orange445/portable-gas-sensor-stm32/README.md

# 便携式气体传感器测量板

本项目使用小型锂电池供电，在阻性气体传感器两端持续施加约 2.000 V，主要测量图示约 0.2–1.6 µA 的单向电流，并为瞬态和样品差异预留约 10 倍电流余量，通过蓝牙把电流、阻值、偏置和电池状态发送到手机或上位机。

## 当前冻结方案

- 传感器：无源阻性器件，默认不含加热器
- 传感器偏置：`VCM - VFORCE ≈ 2.0016 V`
- 主要测量范围：约 0.2–1.6 µA；宽量程告警上限 20 µA，25 µA持续过流关断
- 主要范围对应电阻：约 10 MΩ–1.25 MΩ；25 µA保护点约80 kΩ
- 电流前端：OPA391 宽量程 TIA，`Rf = 12 kΩ`，`Cf = 47 nF`
- 主控：STM32G030F6P6TR，TSSOP-20
- 采集：STM32 12 位 ADC 单端扫描，固件执行差分相减和过采样
- 蓝牙：VG6328A-Pro 串口透传模块，STM32 与模块用 UART 连接
- 供电：单节保护型 LiPo + USB-C/TP4054 充电 + 3.0 V LDO
- 产品方向：低成本、小面积、可调试、适合连续气体/呼吸响应曲线采集

## 设计文档

1. [功能规格](docs/01_功能规格.md)
2. [系统架构与电源树](docs/02_系统架构与电源树.md)
3. [STM32与BLE引脚分配及布局约束](docs/03_BLE引脚分配与布局约束.md)
4. [原理图实施记录](docs/04_原理图实施记录.md)
5. [电学验收与计算](docs/05_电学验收与计算.md)
6. [低成本替换与验收](docs/06_低成本替换与验收.md)
7. [硬件整体结构与关键电流方向](docs/images/06_硬件整体电流图.svg)
8. [项目硬件基线与验证计划](PROJECT_EGFET_BASELINE.md)
9. [STM32CubeMX配置基线](docs/07_STM32CubeMX配置.md)
10. [可导入的CubeMX工程](firmware/cubemx/GasSensor_STM32G030F6.ioc)
11. [固件、串口协议与上位机说明](docs/08_固件与上位机协议.md)
12. [气体传感上位机](tools/serial_curve_plotter.html)

## 当前进度

- [x] 功能与量程冻结
- [x] 电源、充电和模拟前端原理图
- [x] 主控改为 STM32G030F6P6TR
- [x] 独立蓝牙模块、UART、唤醒和电源滤波
- [x] ADC、I2C、复位和 SWD 引脚冻结
- [x] 5针SMD Pogo烧录焊盘加入PCB、不进入BOM
- [x] STM32主去耦统一为0603
- [x] 三页器件按功能分区
- [x] 原理图严格 DRC：无新增错误
- [x] STM32CubeMX 引脚、ADC、DMA、TIM3、UART和I2C配置
- [ ] 封装与 BOM 最终复核
- [ ] PCB 布局布线与 DRC
- [x] STM32 气体采集固件、串口协议与 Web Serial 上位机第一版
- [x] VG6328A-Pro BLE GATT直连、掉线诊断与退避重连
- [x] 已从任务历史精确恢复固件0.2.1：10 Hz默认输出、150 ms预热、经典UART透传流程
- [ ] 样机校准与噪声测试
