orange445/portable-gas-sensor-stm32/PROJECT_EGFET_BASELINE.md

# 便携式气体传感测量板硬件基线

基线编号：`GS-HB-0.2`  
建立日期：2026-07-26  
项目：`GasSensor_Main`  
状态：原理图与固件联调阶段，尚无样机测量证据  
模板来源：`portable-egfet-engineering/project-handoff.md`

> 本项目不是EGFET扫描仪，没有DAC、栅极扫描或电化学参比电极。本基线沿用同一证据链方法，将链路改写为：
>
> `ANA_EN/固定偏置 -> 3VA -> VREF/VCM/VFORCE -> 阻性气体传感器 -> TIA -> STM32 ADC -> 固件换算 -> UART -> BLE -> 上位机`
>
> 本文件同时作为一个“经验来源项目”保存。后续项目只继承设计与调试方法，不自动继承2 V、12 kΩ、STM32引脚、BLE型号、阈值或机械尺寸。

## 1. 证据等级

- `FACT-DESIGN`：从当前设计文档、原理图截图或器件数据手册确认。
- `FACT-EDA-REPORT`：由既有EasyEDA API验收记录确认，但本次未能在线重读。
- `MEASURED`：在具名板卡、仪器和测试条件下得到的实测结果。
- `HYPOTHESIS`：合理但尚未通过区分实验验证。
- `DECISION`：当前选定的实现方法及其取舍。
- `PROPOSED`：建议的验收门槛，尚待项目负责人冻结。
- `WORKAROUND`：临时补偿；当前没有获准的工作绕行项。

当前没有任何 `MEASURED` 证据。本文出现的电压、电流和误差值，除非明确标记为实测，均为标称值、计算值或数据手册边界。

## 2. Objective

### 2.1 科学量

- 主要输出：传感器单向电流 `Isensor`，单位µA或nA。
- 派生输出：传感器实际偏置 `Vsensor`，单位V。
- 派生输出：传感器电阻 `Rsensor = Vsensor / Isensor`，单位Ω。
- 辅助输出：`VCM`、`VFORCE`、`TIA_OUT`、电池电压、USB存在状态、充电状态和质量标志。
- 非当前输出：气体浓度。没有标准气体标定曲线前，不得把电流或阻值直接标成ppm。

### 2.2 设计范围

| 项目 | 当前值 | 证据状态 |
|---|---:|---|
| 主要使用范围 | 0.2–1.6 µA | `FACT-DESIGN`，来自先前实验曲线 |
| 过量程观察范围 | 1.6–20 µA | `DECISION`，尚未实测精度 |
| 软件告警 / 保护关断 | 20 µA / 25 µA | `DECISION` |
| 传感器偏置 | 约2.0016 V | `FACT-DESIGN`，必须在器件带载时测量 |
| 主要范围对应电阻 | 约10.008–1.251 MΩ | 由标称偏置计算 |
| 信号带宽 | 低于数Hz | `FACT-DESIGN` |
| 默认对外数据率 | 20 sample/s | `DECISION`，固件尚未实现 |
| 可选数据率 | 0.1–50 sample/s | `DECISION`，固件尚未实现 |

12 kΩ反馈下0.2 µA仅约3.3个理论差分码，必须通过样机的零点、噪声、过采样和多点校准验证，不能把“有输出码”当作低端准确度。

### 2.3 参考仪器与验收

- 参考仪器：尚未指定。至少需要一台校准有效的6½位DMM，以及0.1%或更高精度、低温漂的80 kΩ、100 kΩ、125 kΩ、1.25 MΩ和10 MΩ电阻。
- 当前已冻结的电压窗口见第11节。
- 电流准确度与重复性尚未由用户冻结。
- `PROPOSED` 首轮工程门槛：校准后电流误差不超过 `max(读数的2%, 20 nA)`，安静台架下固定电阻30分钟重复性不超过10 nA RMS。该门槛需要根据实际应用再确认，当前不能作为已通过指标。

## 3. Hardware Revision

### 3.1 板卡与资料状态

| 项目 | 当前状态 |
|---|---|
| 硬件修订 | `GS-HB-0.2`，TIA宽量程原理图候选 |
| EasyEDA工程 | `GasSensor_Main` |
| 主原理图UUID | `6c0ba00e583160b9` |
| 电源页 | `01_Power_Charge` / `afbb84e5bb136422` |
| 模拟前端页 | `02_AFE_TIA` / `3947cc366d9220d3` |
| STM32/BLE页 | `03_STM32_BLE_Debug` / `9738889853545ddc` |
| PCB/Gerber | PCB存在，但本次电气修改明确未同步到PCB |
| STM32Cube `.ioc` | 已建立；本次Rf/Cf变化不改外设映射 |
| MCU固件/驱动 | 已建立，默认Rf已改为12 kΩ |
| BLE配置与协议 | UART透传协议已建立 |
| 上位机/手机工具 | `tools/serial_curve_plotter.html`已支持气体传感页面 |
| 原始串口记录/CSV | 未找到 |
| 结构件源文件 | 未找到 |

`FACT-EDA-REPORT`：既有记录显示三页共59个实体器件，严格原理图DRC为0错误和4条既有非电气警告。2026-07-26在线确认模拟前端页，并将R17改为12 kΩ、C13改为47 nF后保存；本次没有同步或改动PCB。

`REJECTED/ARCHIVE`：`docs/datasheets/MDBT42Q_512KV2_VerP.pdf`属于旧nRF方案，不是当前STM32 + VG6328A-Pro设计的器件依据。

### 3.2 MCU与时钟

- U7：STM32G030F6P6TR，TSSOP-20。
- Flash/RAM：32 KB / 8 KB。
- 供电与ADC参考：`VDD/VDDA = 3V0`，TSSOP-20中ADC参考内部接VDDA。
- 时钟：CubeMX基线使用内部16 MHz HSI直连，不启用PLL；115200 UART全温误差仍需实测。
- 调试：PA13/PA14 SWD，另有NRST、3V0和GND五针Pogo接口。

### 3.3 电源轨

| 电源/节点 | 标称范围 | 来源 | 当前用途 |
|---|---:|---|---|
| USB_VBUS | 5 V | USB-C | TP4054充电、VBUS检测 |
| BAT | 3.0–4.2 V | 保护型单节LiPo | 系统输入 |
| 3V0 | 3.0 V | ME6211C30M5G | STM32、BLE前级、模拟开关输入 |
| BLE_3V0 | 接近3V0 | 3V0经FB1 | VG6328A-Pro |
| 3VA_SW | 接近3V0 | TPS22919 | 模拟滤波前 |
| 3VA | 约2.93–2.99 V | 3VA_SW经22 Ω | LM4040、TLV9002、OPA391 |
| VREF_2V5_RAW | 约2.5 V | LM4040A25 | 模拟基准 |
| VCM | 约2.5 V | TLV9002-A缓冲 | TIA虚拟地、ADC参考采样 |
| VFORCE | 约0.4984 V | 100 kΩ/24.9 kΩ + TLV9002-B | 传感器低端固定电位 |

### 3.4 连接器与接口

- USB-C：仅5 V充电，不使用USB数据。
- LiPo：实际连接器型号、极性和封装尚未在基线中冻结。
- 传感器：RS1仅为电气模型，不进BOM/PCB；实际电极、焊盘或连接器未冻结。
- J4五针Pogo：1=3V0，2=SWDIO，3=SWDCLK，4=RESET_N，5=GND。
- BLE：U8板载天线，UART和WAKE连接STM32。
- 预留I2C：PA11/PA12，当前没有已装传感器。

## 4. Measurement Chain

### 4.1 完整证据链

| 阶段 | 节点 | 标称范围 | 增益/偏移/极性 | 主要限制 | 证据 |
|---|---|---:|---|---|---|
| 0. 测量启停 | `ANA_EN` | 0/3V0 | 高电平打开TPS22919 | 复位时必须保持低 | `FACT-DESIGN` |
| 1. 模拟电源 | `3VA` | 约2.93–2.99 V | 3V0经开关、22 Ω和本地电容 | 负载、LDO跌落和BLE回流 | `FACT-DESIGN`，待实测 |
| 2. 基准 | `VREF_2V5_RAW` | 约2.5 V | LM4040A25，3.9 kΩ偏置 | 全温最小阴极电流80 µA | 数据手册 + 设计计算 |
| 3. 共模 | `VCM` | 约2.5 V | TLV9002-A单位增益缓冲 | 输出摆幅、负载与温漂 | `FACT-DESIGN` |
| 4. 低端偏置 | `VFORCE` | 约0.498399 V | `2.5×24.9/(100+24.9)` | 分压误差、缓冲失调 | 设计计算 |
| 5. 被测器件 | `SENS_H`到`VFORCE` | 约2.001601 V | `Vsensor=VCM−VFORCE` | 必须测器件两端实际电压 | 设计计算，待实测 |
| 6. 传感器电流 | `Isensor` | 主范围0.2–1.6 µA，保护点25 µA | 常规电流从SENS_H/VCM侧经传感器流向VFORCE | 开路、漏电、污染、寄生电容 | `FACT-DESIGN` |
| 7. 跨阻转换 | `TIA_OUT` | 主范围2.5024–2.5192 V，保护点2.800 V | `TIA_OUT=VCM+Isensor×12 kΩ` | OPA391高端共模/输出余量、Rf/Cf | 设计计算 + 数据手册 |
| 8. ADC输入网络 | `AIN_TIA/VCM/VFORCE` | 0.498–2.800 V | 各串1 kΩ、各10 nF到GND | 通道切换和电容重分配 | `FACT-DESIGN` |
| 9. ADC码 | PA0/PA1/PA4 | 0–4095码 | 3.0 V时0.7326 mV/LSB | ADC TUE、INL、VDDA、采样时间 | STM32数据手册 |
| 10. 数字差分 | `Vdiff` | 主范围2.4–19.2 mV，保护点300 mV | `V(TIA)−V(VCM)` | 两次单端采样并非同时采样 | 固件已实现 |
| 11. 电流换算 | `Isensor` | 主范围0.2–1.6 µA | `(Vdiff−Vzero)/Rf_cal` | 校准系数和单位 | 固件已实现 |
| 12. 电阻换算 | `Rsensor` | 主范围1.251–10.008 MΩ | `(VCM−VFORCE)/Isensor` | 小电流时除法敏感 | 固件已实现 |
| 13. 串口帧 | USART2 | 默认候选115200 bit/s | PA2 TX到U8 RX，PA3 RX来自U8 TX | 帧格式、CRC、拥塞尚未定义 | 原理图确认，协议缺失 |
| 14. 无线链路 | VG6328A-Pro | BLE透传 | 模块承担射频与BLE | 服务UUID、睡眠和重连策略缺失 | `FACT-DESIGN` |
| 15. 用户输出 | 手机/上位机 | 未定义 | 应显示原始量、校准量和质量标志 | 主机工具与CSV格式缺失 | 未实现 |

### 4.2 独立计算

```text
VFORCE = 2.5 × 24.9 / (100 + 24.9)
       = 0.4983987 V

Vsensor = 2.5 - 0.4983987
        = 2.0016013 V

ADC_LSB = 3.0 / 4095
        = 0.7326007 mV

I_LSB_nominal = ADC_LSB / 12 kΩ
              = 61.050 nA/LSB

fTIA = 1 / (2π × 12 kΩ × 47 nF)
     = 282.19 Hz
```

| 电流 | 等效电阻 | `TIA_OUT` | 标称差分码 |
|---:|---:|---:|---:|
| 0.2 µA | 10.008 MΩ | 2.5024 V | 3.28 |
| 1.6 µA | 1.251 MΩ | 2.5192 V | 26.21 |
| 16 µA | 125.1 kΩ | 2.692 V | 262.08 |
| 20 µA | 100.08 kΩ | 2.740 V | 327.60 |
| 25 µA | 80.06 kΩ | 2.800 V | 409.50 |

### 4.3 关键边界

1. `FACT-DATASHEET`：STM32G030 ADC的总未调整误差在数据手册条件下典型3 LSB、最大6.5 LSB；ENOB典型约10.2 bit。0.2 µA只有3.28个理论差分码，因此过采样不能替代零点、增益和多点校准。
2. `FACT-DATASHEET`：12位ADC在35 MHz时，1 kΩ源阻从7.5个采样周期开始满足数据手册表格条件；本项目仍应选更长采样时间，并验证各通道10 nF对地电容后的通道切换。
3. `FACT-DESIGN`：AIN_TIA、AIN_VCM和AIN_VFORCE各有1 kΩ串联与10 nF对地，单路名义极点约15.9 kHz。扫描顺序和等待时间必须通过示波器/ADC原始码验证，不能只按单路RC估算。
4. `FACT-DATASHEET`：OPA391无负载输出典型距电源轨3 mV、最大约10 mV；设计最大输出2.800 V对最低估计3VA=2.93 V仍有约130 mV余量。余量看似足够，但必须在温度、BLE发射和低电池条件下实测。
5. `FACT-DATASHEET`：OPA391在接近正电源轨的高共模区域精度规格变差。本设计VCM约2.5 V、3VA约2.93–2.99 V，应把TIA零点随温度和电源的变化纳入校准。
6. `FACT-DATASHEET`：LM4040A25全温最小阴极电流为80 µA。3VA=2.93 V时，经3.9 kΩ的标称电流约110 µA，只有约30 µA余量；应实测最低电池、最高温和器件容差组合。

## 5. Peripheral Configuration

### DAC

- 无DAC。
- 固定偏置由LM4040、TLV9002和电阻比产生。
- 任何未来加入可变偏置或扫描功能的改动，都必须重新建立DAC设定值到器件实际端电压的证据链。

### ADC

- MCU：STM32G030F6P6TR内部12位ADC。
- 固定扫描顺序：PA0 `AIN_TIA`、PA1 `AIN_VCM`、PA4 `AIN_VFORCE`、PA5 `BAT_SENSE`、PA6 `VBUS_SENSE`、内部`VREFINT`。
- `CHG_STAT_N`：PA7数字输入。
- CubeMX基线：ADC时钟4 MHz、160.5周期采样、64×硬件过采样/右移6位、TIM3 TRGO 20 Hz触发、DMA1 Channel 1循环搬运6个半字。
- ADC自校准、模拟前端稳定等待和丢弃前2帧属于固件启动状态机，不能仅依赖CubeMX生成代码。
- 配置文件：`firmware/cubemx/GasSensor_STM32G030F6.ioc`。

### UART/BLE

- USART2：PA2 TX、PA3 RX。
- 基线波特率：115200 bit/s、8-N-1；内部RC全温误差尚未验证。
- `BLE_WAKE`：PB6到U8 PA9，空闲高电平、下降沿脉冲唤醒。
- AT命令版本、服务UUID、连接参数、批量发送策略：未定义。

### 定时器与时间戳

- TIM3以16 MHz时钟、PSC=15999、ARR=49产生20 Hz硬件触发。
- ADC DMA每次触发输出一帧6个过采样结果；样本序号、时间戳宽度、溢出规则和丢帧处理仍由应用固件定义。

## 6. Calibration

### 6.1 必须保存的原始量

- 每个ADC通道的原始码。
- VREFINT原始码和换算后的VDDA。
- `TIA_OUT`、`VCM`、`VFORCE`的平均值与标准差。
- `BAT_SENSE`、`VBUS_SENSE`、充电状态。
- BLE发射/连接状态、样本序号和时间戳。
- 板号、硬件修订、固件版本、校准日期和环境温度。

### 6.2 电压校准

1. 使用DMM测量3V0、3VA、VCM、VFORCE和TIA_OUT。
2. 同步记录ADC原始码和VREFINT。
3. 建立每块板的ADC增益/偏移或至少验证VREFINT换算误差。
4. 验证带载传感器两端的实际 `VCM - VFORCE`，不使用固定2.000 V替代实测值。

### 6.3 电流校准

使用精密电阻代替传感器：

| 目标电流 | 标称电阻 |
|---:|---:|
| 0 µA | 开路 |
| 0.2 µA | 约10 MΩ |
| 1.6 µA | 约1.25 MΩ |
| 16 µA | 约125 kΩ |
| 20 µA | 约100 kΩ |
| 25 µA | 约80 kΩ |

每点至少记录正向上电重复、30分钟稳定性和BLE开/关两组数据，拟合：

```text
Isensor = (Vdiff - Vzero) / Rf_cal
```

不能通过单一软件偏移掩盖随电流变化的增益误差、TIA余量或ADC非线性。

### 6.4 温度

- 当前没有板载温度传感器。
- PA11/PA12保留I2C，可后续加温湿度传感器。
- 温度补偿模型和系数尚未建立；在没有气体/温湿度联合标定前，只能输出原始电学量。

## 7. Protocol

- 命令：未定义。
- 数据帧：未定义。
- 质量/错误帧：未定义。
- CRC：计划需要，但算法未定义。
- 版本字段：未定义。
- 单位：建议线上统一使用整数基本单位，例如nA、µV、mV、mΩ或定点比例，避免主机与固件浮点解释不一致。
- 必需质量标志建议包括：`ADC_SAT`、`BIAS_OOR`、`CURRENT_OOR`、`SENSOR_OPEN`、`LOW_BAT`、`USB_PRESENT`、`CHARGING`、`BLE_TX_ACTIVE`、`CAL_INVALID`。

## 8. Confirmed Observations

- `FACT-DESIGN`：当前设计采用固定约2 V偏置、OPA391 + 12 kΩ单量程TIA，不使用惠斯通电桥。
- `FACT-DESIGN`：STM32分别采集TIA_OUT、VCM和VFORCE，在固件中做差，可跟踪共模和实际偏置。
- `FACT-DESIGN`：模拟前端可通过TPS22919独立关断。
- `FACT-DESIGN`：BLE供电经磁珠和本地4.7 µF/100 nF去耦，布局目标是让射频脉冲电流在模块附近闭合。
- `FACT-EDA-REPORT`：U7为STM32G030F6P6TR，U8为VG6328A-Pro，J4为可进入PCB的五针Pogo封装。
- `FACT-DATASHEET`：STM32G030提供12位ADC、硬件过采样、DMA、VREFINT和SWD，功能资源足以实现当前采集链。
- `MEASURED`：无。尚未有具名样机、仪器、环境和原始数据。

## 9. Inherited Design Experience

以下经验可以继承到后续便携式微弱电流/阻性传感项目：

1. `DECISION`：先按真实实验范围缩窄量程，再选跨阻增益；不要为未出现的nA到mA六个数量级增加自动量程。
2. `DECISION`：对单向微安电流优先使用TIA；兆欧级惠斯通电桥会增加漏电、匹配、温漂和面积问题。
3. `DECISION`：同时采集信号节点、共模节点和偏置节点；不能把标称2 V当成器件实际偏置。
4. `DECISION`：用单3 V电源完成模拟和数字系统，避免不必要的升压、电感纹波和ADC过压风险。
5. `DECISION`：将模拟电源与BLE脉冲电流在供电和布局上隔离，并给采样数据增加射频活动标志。
6. `DECISION`：保留SWD、NRST和供电测试点；无线链路不能成为唯一烧录或恢复路径。
7. `DECISION`：充电器没有电源路径管理时，充电状态不应默认等同于精密测量状态。
8. `DECISION`：未完成标准气体标定前，只报告电流、阻值和环境量，不宣称浓度。
9. `DECISION`：保留原始ADC码和稳健平均后的科学数据；仅在显示层做视觉平滑。
10. `DECISION`：每个项目专用的电压、引脚、增益、封装、天线禁布和机械尺寸都必须在目标板重新确认，不能只凭旧项目经验复制。

### 9.1 本项目设计和调试过程中已经暴露的坑

| 踩坑/演进 | 得到的经验 | 后续项目的检查动作 |
|---|---|---|
| 最初按2 nA–2 mA的六个数量级规划，电路复杂度迅速上升 | 先从真实实验曲线冻结主要范围，再留有依据的冗余 | 在选ADC和Rf前写明主要范围、保证范围和明确不覆盖范围 |
| 最初考虑H桥/惠斯通电桥，希望抑制温漂 | 兆欧传感器下，桥臂匹配、漏电、面积和激励稳定性可能比差模收益更差 | 比较电桥与TIA的总误差、漏电路径和校准复杂度，不只比较拓扑名称 |
| 早期只关注采集核心，容易漏掉LDO、去耦、复位、烧录和低电量状态 | 芯片能画进原理图不代表系统能上电、烧录或恢复 | 每个IC都检查供电、去耦、复位、启动默认态、测试点和故障安全状态 |
| 一体化STM32WB/nRF方案功能完整但成本过高 | 低成本设计要把芯片价格、射频风险、面积、平均电流和软件职责一起比较 | 在冻结BOM前做1片/10片成本与面积、续航对比 |
| 改为STM32 + BLE模块后，UART、WAKE、模块供电和天线禁布成为新约束 | 降成本通常会把复杂度转移到接口、布局和功耗 | 替换器件时同步更新供电树、引脚表、布局和固件职责边界 |
| TSSOP-20符号存在多个内部GPIO共用一个外部封装脚 | 只看功能复用表可能造成固件同时驱动同一物理脚 | 以封装脚为主键审计引脚；未用的共封装GPIO保持模拟输入 |
| 临时J4符号曾出现8针符号、6焊盘封装且不进入PCB | DRC通过不代表调试接口会出现在PCB上 | 检查符号针数、封装焊盘数、BOM/PCB标志和实际网络一一对应 |
| C16替换成0603并旋转后，曾出现图形在位但引脚未真正接通 | 器件替换或旋转后必须检查电气连接，不可只看画面 | 读取引脚坐标/连接状态，保存后再跑严格DRC和网络审计 |
| RS1只是传感器电气模型，没有真实PCB封装 | 原理图功能冻结不能替代机械接口冻结 | PCB前取得实物尺寸、引脚材料、连接方式和清洁/漏电要求 |
| Rf从120 kΩ降为12 kΩ后，低端0.2 µA只有约3.3码 | 过流余量与低端分辨率直接冲突，不能只看满量程不越轨 | 保留原始码，用精密电阻做零点、多点增益和重复性验证 |
| 采用两个单端通道相减，并给三路各加10 nF对地电容 | 通道扫描顺序、采样时间和电容电荷重分配会形成系统误差 | 改变扫描顺序/采样时间并对比，必要时丢弃切换后的首样本 |
| BLE与微弱模拟量共板 | 无线脉冲可能通过电源和地回流污染TIA/ADC | 同步记录BLE状态，做关闭、广播、连接三组A/B测试 |
| TP4054没有系统电源路径管理 | 边充边测可能引入噪声，并影响充电终止判断 | 默认充电时暂停精密测量；若产品必须边充边测则重做电源路径 |
| 只测电流而直接谈气体浓度 | 电学响应不是浓度，湿度和样品差异会改变映射 | 标准气体、温湿度和重复样本标定完成前只输出电流/阻值 |

### 9.2 建议长期继承的调试顺序

1. 先空载上电，确认电源轨、复位和SWD，不接传感器。
2. 再验证固定偏置：分别测VCM、VFORCE以及器件端实际差值。
3. 用开路和精密电阻替代传感器，逐点验证TIA极性、增益和余量。
4. 同步保存DMM读数、ADC原始码、VREFINT和时间戳，不先加软件补偿。
5. 先在BLE关闭时建立安静基线，再开启广播和连接做A/B测试。
6. 改变一个变量后重复同一测试；不要同时改Rf、滤波、采样时间和平均次数。
7. 只有确认误差是稳定、可重复、可加性的，才允许增加软件offset。
8. 最后接真实传感器，并记录板号、传感器、气体、湿度、温度、流量和测试时序。

## 10. Open Hypotheses

| 假设 | 区分实验 | 判定依据 |
|---|---|---|
| 64–256次过采样后可稳定分辨0.2 µA | 10 MΩ替代传感器，记录原始码、均值、RMS和漂移 | 与第2.3节门槛比较 |
| 47 nF可保证不同传感器电容下TIA稳定 | 开路、80 kΩ和传感器等效电容阶跃 | 无持续振铃，建立时间满足输出速率 |
| BLE发射不会显著污染电流结果 | 同一固定电阻，BLE关闭/广播/连接三组同步采样 | 均值和频谱差异低于允许误差 |
| 3VA最低条件仍能让TIA输出2.8 V | 低电池、高温、25 µA负载同时测试 | TIA_OUT无压缩，3VA和VCM在窗口内 |
| 内部RC可稳定支持115200 UART | 高低温、低电池、长包压力测试 | 无帧错误、AT失步或重连异常 |
| 10 nF对地电容不会造成扫描残留 | 改变ADC采样时间、顺序和丢弃首样本策略 | 相邻通道码不随顺序产生系统偏差 |
| 200–300 mAh电池满足目标续航 | 最终固件和连接参数下记录电池电流积分 | 以产品续航要求判定，当前要求未冻结 |
| 现有护环与布局可控制兆欧节点漏电 | 清洁/污染/高湿三组开路与20 MΩ测试 | 开路等效漏电和漂移低于误差预算 |

## 11. Decisions

| 决策 | 原因 | 取舍 | 验证 |
|---|---|---|---|
| 固定约2 V偏置 | 延续实验条件，结构简单 | 不能执行扫描 | 实测器件两端电压 |
| 12 kΩ单量程TIA | 主量程0.2–1.6 µA并留约十倍电流余量 | 低端仅约3.3码 | 多点校准、过采样和噪声测试 |
| STM32G030内部ADC | 低成本、小面积、资源够用 | 精度低于独立高精度ADC | 首板误差预算决定是否升级 |
| STM32 + 独立BLE模块 | 降低成本和射频开发风险 | 面积和平均电流增加 | 实测续航和射频耦合 |
| 3.0 V单电源 | 去掉升压与纹波源 | TIA高端余量有限 | 最差电源组合测试 |
| 模拟电源可关断 | 降功耗并提供故障安全状态 | 上电需等待稳定 | 上下电时序和放电测试 |
| 充电时暂停精密测量 | TP4054无系统电源路径 | 充电时数据中断 | 若必须边充边测，重新设计电源路径 |

## 12. Mechanical

- PCB目标：首版不大于45 × 25 mm，优化目标约35 × 25 mm。
- 数字/射频功能块估计：约22 × 16 mm；不是实际PCB尺寸。
- U8模块：约14.5 × 11.5 mm，必须置于板边。
- STM32 TSSOP-20：约6.4 × 4.4 mm封装体。
- PCB厚度、安装孔、传感器坐标、USB坐标、电池位置和外壳：未冻结。
- 天线下方及前方需要全层禁铜、禁走线、禁过孔、禁器件，并远离电池和金属壳。

## 13. Known Risks

| 风险 | 检测方法 | 缓解措施 |
|---|---|---|
| 0.2 µA绝对精度不足 | 多点电阻校准与误差预算 | 校准、长采样、过采样；必要时改外置ADC或提高Rf |
| ADC单端相减误差 | 同时记录各通道原始码与DMM | 通道校准、固定顺序、首样本丢弃、验证采样时间 |
| TIA接近正轨时压缩 | 低3VA下施加25 µA | 保留余量；必要时降低保护阈值 |
| 高湿/污染导致兆欧节点漏电 | 开路和20 MΩ高湿测试 | 护环、阻焊策略、清洗与三防评估 |
| 传感器电容导致TIA振铃 | 等效电容阶跃和波形检查 | 调整Cf，保持反馈回路最短 |
| BLE回流污染模拟量 | BLE状态同步的时域/频域对比 | 模块本地去耦、布局隔离、采发错峰 |
| LM4040电流余量不足 | 最低3VA和全温参考电压 | 调整3.9 kΩ，重新核算功耗和负载 |
| TP4054无电源路径 | 充电时电压、噪声和终止行为 | 精密测量暂停；产品需要时增加电源路径 |
| 传感器无PCB封装 | PCB网表/BOM审计 | 在布局前冻结实际机械接口 |
| 固件和协议缺失 | 构建与串口回放测试 | 同步实现采集、协议和主机解析 |
| 项目无版本控制证据 | 设计变更追踪检查 | 冻结原理图/PDF/BOM/固件版本并归档 |

## 14. 首板上电验收

| 测试点 | 当前设计窗口 | 证据要求 |
|---|---:|---|
| 3V0 | 2.94–3.06 V | DMM + 示波器纹波 |
| BLE_3V0 | 接近3V0 | 广播/连接脉冲下无异常跌落 |
| 3VA | ANA_EN后不低于约2.93 V | 最低电池与最大负载 |
| VREF_2V5_RAW | 25 °C初检2.4975–2.5025 V | DMM，记录参考电流 |
| VCM | 与VREF差值不大于3 mV | DMM + ADC原始码 |
| VFORCE | 0.495–0.502 V | DMM + ADC原始码 |
| `VCM−VFORCE` | 未校准1.990–2.010 V | 必须在传感器带载时测量 |
| 开路TIA_OUT | 接近VCM | 记录零点与漂移 |
| 0.2 µA等效输入 | 差分约2.4 mV | 10 MΩ替代件 |
| 1.6 µA等效输入 | 差分约19.2 mV | 约1.25 MΩ替代件 |
| 25 µA等效输入 | 差分约300 mV | 约80 kΩ替代件，无压缩 |
| SWD | 可识别、擦除、烧录、断点 | ST-LINK |
| BLE UART | AT响应和长包无错 | 串口日志 |
| ANA_EN关断 | 3VA按预期放电 | 示波器时序 |

## 15. 下一项最有区分力的实验

首板完成后，先不要接真实气敏材料。使用开路、10 MΩ、1.25 MΩ、125 kΩ、100 kΩ和约80 kΩ精密电阻构成替代负载，同时记录：

1. DMM测得的3V0、3VA、VCM、VFORCE、TIA_OUT。
2. STM32五个ADC通道的原始码、VREFINT、平均值和标准差。
3. BLE关闭、广播和连接三种状态。
4. 低电池正常点与接近3.25 V边界点。
5. 每点至少10分钟，0.2 µA点建议30分钟。

这个实验可一次区分：ADC低端分辨能力、通道相减误差、TIA高端余量、BLE耦合、参考电流余量和校准是否可行。

## 16. Completion Note

- 本次建立了从固定偏置到用户输出的完整硬件/数据链。
- 独立重算确认了标称偏置、TIA量程、ADC码数和反馈极点。
- 当前确认的是原理图设计覆盖，不是样机精度或浓度准确度。
- 尚未解决：传感器机械接口、PCB、固件、协议、校准设备、实测误差和续航。
- 主要原始依据：
  - `README.md`
  - `docs/01_功能规格.md`
  - `docs/02_系统架构与电源树.md`
  - `docs/03_BLE引脚分配与布局约束.md`
  - `docs/04_原理图实施记录.md`
  - `docs/05_电学验收与计算.md`
  - `docs/06_低成本替换与验收.md`
  - `docs/images/01_Power_Charge.png`
  - `docs/images/02_AFE_TIA.png`
  - `docs/images/03_BLE_Debug.png`
- 下一步：执行第15节替代电阻实验，并把原始CSV、仪器型号、板号和环境条件回填到本基线。
