orange445/portable-gas-sensor-stm32/docs/03_BLE引脚分配与布局约束.md

# 03 STM32与BLE引脚分配及布局约束

版本：V0.3  
页面：`03_STM32_BLE_Debug`

## 1. 选型结论

- U7：STM32G030F6P6TR，TSSOP-20，立创编号 C529330
- U8：VG6328A-Pro，板载PCB天线，立创编号 C53263476
- 通信：3.0 V UART，默认可按模块资料从 115200 bit/s开始
- 调试：STM32使用SWD；蓝牙使用UART AT命令配置

这套组合比STM32WB1MMCH6TR便宜，主控软件仍使用常见STM32工具链，射频设计风险由成品蓝牙模块承担。

## 2. 冻结引脚表

| U7引脚 | STM32功能 | 网络 | 方向/说明 |
|---:|---|---|---|
| 4 | VDDA/VDD | `3V0` | 主控与ADC供电 |
| 5 | VSSA/VSS | `GND` | 地 |
| 6 | NRST | `RESET_N` | 10 kΩ上拉、100 nF到地、接SWD测试点 |
| 7 | PA0 / ADC_IN0 | `AIN_TIA` | TIA输出采样 |
| 8 | PA1 / ADC_IN1 | `AIN_VCM` | VCM采样 |
| 9 | PA2 / USART2_TX | `BLE_UART_TX` | STM32发送到U8 RXD |
| 10 | PA3 / USART2_RX | `BLE_UART_RX` | U8 TXD发送到STM32 |
| 11 | PA4 / ADC_IN4 | `AIN_VFORCE` | VFORCE采样 |
| 12 | PA5 / ADC_IN5 | `BAT_SENSE` | 电池分压 |
| 13 | PA6 / ADC_IN6 | `VBUS_SENSE` | USB分压 |
| 14 | PA7 | `CHG_STAT_N` | 充电状态输入 |
| 15 | PB0 | `ANA_EN` | 模拟电源开关控制 |
| 16 | PA11 / I2C2_SCL | `I2C_SCL` | 预留温湿度传感器；保持默认映射 |
| 17 | PA12 / I2C2_SDA | `I2C_SDA` | 预留温湿度传感器；保持默认映射 |
| 18 | PA13 | `SWDIO` | ST-LINK |
| 19 | PA14 | `SWDCLK` | ST-LINK |
| 20 | PB6 | `BLE_WAKE` | 控制U8 PA9下降沿唤醒 |

原理图库符号中部分 TSSOP-20 封装脚会显示多个被键合到同一外部脚的GPIO名称。固件必须只启用上表指定GPIO，并把同一封装脚上的其余GPIO保持为模拟输入。特别注意：

- 15脚使用PB0；PB1、PB2、PA8保持模拟输入
- 19脚保留PA14/SWCLK；PA15保持模拟输入
- 20脚使用PB6；PB3、PB4、PB5保持模拟输入
- 16/17脚默认作为PA11/PA12使用I2C2；不要启用PA9/PA10重映射

U7的1、2、3脚首版不用，已明确标记NC；不得在PCB阶段随意复用而不更新本表。

## 3. 蓝牙模块连接

| U8引脚 | 模块功能 | 网络 | 连接 |
|---:|---|---|---|
| 1 | RXD | `BLE_UART_TX` | 来自STM32 PA2 |
| 2 | TXD | `BLE_UART_RX` | 到STM32 PA3 |
| 3 | GND | `GND` | 就近多过孔接地平面 |
| 4 | VDD | `BLE_3V0` | 经FB1供电 |
| 5 | PA9 | `BLE_WAKE` | 下降沿唤醒 |

其余模块引脚按资料保持默认/未连接，除非后续固件方案明确需要。

## 4. 供电与最小系统

```text
3V0 → FB1 GZ1005D601TF → BLE_3V0
BLE_3V0 → C20 4.7 µF || C21 100 nF → GND

3V0 → U7 VDD/VDDA
3V0 → C16 4.7 µF（0603）|| C17 100 nF（0402）→ GND

3V0 → R21 10 kΩ → RESET_N
RESET_N → C22 100 nF → GND
```

R22/R23为I2C的4.7 kΩ上拉。J4使用5针SMD Pogo封装 `CONN-SMD_C9900014775`，不进入BOM但必须转入PCB，依次连接3V0、SWDIO、SWDCLK、RESET_N和GND。

首版STM32使用内部时钟，不需要外部晶振，避免增加面积、成本和起振问题。

## 5. 布局顺序

推荐从板边向内：

```text
板外
┌──────────────────────────────────────┐
│ [U8 PCB天线/禁布区] [U8模块主体]     │
│                       [FB1 C20 C21]   │
│                       [U7 STM32]      │
│              [R18/R19/R20 C18/C19]   │
│ [传感器接口] [OPA391/反馈] [SWD焊盘] │
└──────────────────────────────────────┘
```

实际分区应保持：

- U8天线在PCB边缘，天线朝外
- U8主体与U7靠近，UART尽量短
- FB1、C20、C21紧贴U8 VDD/GND，电容地回路最短
- C16/C17紧贴U7供电脚；C22和R21紧贴NRST
- R18/R19/R20、C18/C19靠近U7 ADC引脚，而不是靠近AFE输出端
- OPA391、Rf/Cf和传感器高阻节点形成最小闭环
- SWD测试点放在板边或板底可接触区域

## 6. 走线优先级

1. `SENS_H`、OPA391反相输入、Rf/Cf：最短、无过孔、远离数字边沿
2. `VCM`、`VFORCE`、`TIA_OUT`到ADC RC：成组、短、避免与UART平行
3. U7去耦、U8去耦和地回流：先布，回路面积最小
4. `SWDIO/SWDCLK`：短且可访问，不从天线或高阻节点下方穿过
5. UART和`BLE_WAKE`：普通数字线，但避免紧贴AIN走线
6. I2C：低优先级预留，可放外层并远离高阻模拟节点

## 7. 天线和地

- U8天线端必须伸到板边
- 天线正下方和前方按厂家封装设置所有铜层、走线、过孔和器件禁布
- 电池、金属壳、USB外壳和传感器金属结构不得覆盖天线
- 模块GND焊盘附近使用多颗接地过孔
- 不把模拟地切成悬空小岛；使用连续地平面，通过布局控制回流路径
- BLE供电/回流不得穿过OPA391、VCM或ADC参考区域

## 8. 固件初始化约束

- 上电后SWD保持可用，不要在早期初始化中重映射PA13/PA14
- 先初始化UART，再测试模块AT响应
- USART2使用PA2/PA3
- ADC顺序固定为 PA0、PA1、PA4、PA5、PA6
- `ANA_EN`上电默认低，完成系统检查后再置高
- `BLE_WAKE`空闲保持不会误触发模块的电平；唤醒使用明确下降沿脉冲
- I2C2使用PA11/PA12默认映射；不要设置PA9/PA10重映射位
- 初始化15、19、20脚时，同一封装脚上的其余键合GPIO必须保持模拟输入

## 9. PCB完成前检查表

- [ ] U7、U8和J4封装焊盘编号与原理图一致
- [ ] U8天线禁布区在所有铜层生效
- [ ] 3V0、BLE_3V0和3VA未误短接
- [ ] UART TX/RX交叉正确
- [ ] NRST有上拉、电容和测试点
- [ ] SWDIO/SWDCLK未被其他功能占用
- [ ] ADC RC靠近U7且模拟线不穿越天线/UART区域
- [ ] U7和U8每个电源地连接均有低阻回流
