orange445/portable-gas-sensor-stm32/docs/04_原理图实施记录.md

# 04 原理图实施记录

版本：V0.4  
项目：`GasSensor_Main`

## 1. 页面结构

| 页面 | UUID | 内容 |
|---|---|---|
| `01_Power_Charge` | `afbb84e5bb136422` | USB-C、充电、电池、3V0、3VA开关和电源检测 |
| `02_AFE_TIA` | `3947cc366d9220d3` | 2.5 V基准、VCM/VFORCE、OPA391 TIA和传感器 |
| `03_STM32_BLE_Debug` | `9738889853545ddc` | STM32、ADC RC、BLE、UART、I2C、复位和SWD |

## 2. 本次主控替换

已删除昂贵的STM32WB1MMCH6TR方案，改为：

| 位号 | 功能 | 器件 | 立创编号 |
|---|---|---|---|
| U7 | 主控和ADC | STM32G030F6P6TR | C529330 |
| U8 | BLE串口模块 | VG6328A-Pro | C53263476 |
| FB1 | BLE供电隔离 | GZ1005D601TF，600 Ω@100 MHz，0402 | C14182 |
| C20 | BLE储能 | 4.7 µF，0603 | C1705 |
| C21 | BLE高频去耦 | 100 nF，0402 | C1525 |
| C22 | STM32复位电容 | 100 nF，0402 | C1525 |
| C16 | STM32储能去耦 | 4.7 µF，0603 | C1705 |
| J4 | 5针SMD Pogo烧录焊盘 | `CONN-SMD_C9900014775` | 不进入BOM |

保留既有 C17 100 nF、R21 10 kΩ、R22/R23 4.7 kΩ以及R18/R19/R20、C18/C19 ADC滤波网络。C16已由0805缩小为与C20相同的0603器件；J4已由引脚/焊盘数不一致的临时器件替换为真正的5针SMD Pogo封装。

## 3. 已实施网络

### 3.1 STM32

| 网络 | U7连接 |
|---|---|
| `3V0` | VDD/VDDA |
| `GND` | VSS/VSSA |
| `RESET_N` | NRST |
| `AIN_TIA` | PA0 |
| `AIN_VCM` | PA1 |
| `BLE_UART_TX` | PA2 / USART2_TX |
| `BLE_UART_RX` | PA3 / USART2_RX |
| `AIN_VFORCE` | PA4 |
| `BAT_SENSE` | PA5 |
| `VBUS_SENSE` | PA6 |
| `CHG_STAT_N` | PA7 |
| `ANA_EN` | PB0 |
| `I2C_SCL` | PA11 / I2C2_SCL，默认映射 |
| `I2C_SDA` | PA12 / I2C2_SDA，默认映射 |
| `SWDIO` | PA13 |
| `SWDCLK` | PA14 |
| `BLE_WAKE` | PB6 |

符号中的复用引脚名称较长，PCB和固件以本表为准。TSSOP-20的15、19、20脚各键合多个内部GPIO；只能启用本表指定GPIO，其余保持模拟输入。16/17脚保持PA11/PA12默认映射，不切换成PA9/PA10。U7的1、2、3脚已显式标记NC。

### 3.2 BLE

```text
U8.1 RXD ← BLE_UART_TX
U8.2 TXD → BLE_UART_RX
U8.3 GND → GND
U8.4 VDD ← BLE_3V0
U8.5 PA9 ← BLE_WAKE
```

```text
3V0 → FB1 → BLE_3V0
BLE_3V0 → C20 4.7 µF || C21 100 nF → GND
```

### 3.3 复位和烧录

```text
3V0 → R21 10 kΩ → RESET_N
RESET_N → C22 100 nF → GND
J4.1：3V0
J4.2：SWDIO
J4.3：SWDCLK
J4.4：RESET_N
J4.5：GND
```

该连接允许使用ST-LINK完成空片烧录、断点调试和故障恢复，不依赖蓝牙模块。

## 4. 设计理念保持不变

- 传感器两端持续约2.0 V
- OPA391 + 12 kΩ/47 nF宽量程TIA，主要测量0.2–1.6 µA，并为瞬态预留约10倍余量
- STM32分别采集TIA_OUT、VCM和VFORCE，软件相减形成差模结果
- 通过同时测量两个相关节点抵消基准缓慢漂移，而不是依赖四臂电桥
- 模拟前端可通过`ANA_EN`关断
- 蓝牙电源和回流与微弱模拟区域隔离

## 5. DRC结果

修改、去耦缩小和J4封装修正后均已保存，并再次执行严格原理图DRC：

```text
错误：0
致命错误：0
新增警告：0
现存警告：4
```

4条为原设计已有的非连接性提示：

1. `VCM_GUARD`只有一个实体器件引脚，另一端用于PCB护环铜皮
2. TLV9002多单元器件的本地供应商后缀提示
3. 两条早期本地库器件标准化提示

这些提示不构成电气豁免。PCB前仍需核对封装焊盘编号、器件方向和BOM料号。

## 6. 烧录与启动

- STM32首版使用内部时钟，不装外部晶振
- 建议先以低速、简单时钟树完成最小系统点亮和SWD验证
- USART2 PA2/PA3连接蓝牙模块，先验证AT命令和透传，再加入ADC数据
- `ANA_EN`必须在复位阶段保持低
- 固件应启用独立看门狗，并对蓝牙UART设置超时，模块失联不能阻塞采样

## 7. PCB下一步

1. 锁定U8在板边和天线全层禁布区
2. 锁定U7、C16/C17、R21/C22与J4
3. 把R18/R19/R20、C18/C19贴近U7 ADC引脚
4. 布置OPA391、Rf/Cf和传感器接口，形成最小高阻回路
5. 布置FB1、C20/C21，使BLE脉冲电流在模块附近闭合
6. 最后布UART、I2C、LED和低优先级控制线
7. 完成天线禁布、地回流、阻焊开窗和测试点检查

## 8. 资料

- [STM32G030F6产品页](https://www.st.com/en/microcontrollers-microprocessors/stm32g030f6.html)
- [STM32G030F6数据手册](https://www.st.com/resource/en/datasheet/stm32g030f6.pdf)
- [VG6328A-Pro资料](https://atta.szlcsc.com/upload/public/pdf/source/20260701/2E43CC04C6263D77978C2A5830BC3F43.pdf)
