orange445/portable-gas-sensor-stm32/docs/05_电学验收与计算.md

# 05 电学验收与计算

版本：V0.4  
验收对象：STM32 + 独立 BLE 三页原理图

## 1. 验收结论

| 项目 | 设计值或结果 | 判定 |
|---|---:|---|
| 传感器标称偏置 | 2.0016 V | 通过 |
| 未校准偏置估计 | 约1.995–2.008 V | 通过 |
| 主要检测电流 | 0.2–1.6 µA | 待样机验证低端噪声 |
| 过量程观察 / 保护关断 | 20 µA / 25 µA | 设计覆盖 |
| 主要范围对应传感器电阻 | 约10 MΩ–1.25 MΩ | 通过 |
| 图示主要电流范围 | 约0.2–1.6 µA | 完整覆盖 |
| TIA输出 | 主范围2.5024–2.5192 V；保护点2.800 V | 通过 |
| STM32 ADC原始电流分辨率 | 约61.1 nA/LSB | 低端必须过采样与校准 |
| 主控烧录 | SWDIO/SWDCLK/NRST | 完整 |
| 主控与BLE通信 | USART2 + WAKE | 完整 |
| 严格原理图DRC | 无错误、4条既有提示 | 通过 |

本方案不使用四臂惠斯通电桥。STM32分别采集 `TIA_OUT`、`VCM` 和 `VFORCE`，在固件中计算 `TIA_OUT - VCM` 与 `VCM - VFORCE`，保留差模测量和基准漂移抵消，同时避免兆欧级桥臂带来的漏电、匹配和面积问题。

## 2. 2 V偏置

```text
VFORCE = 2.5 × 24.9k / (100k + 24.9k)
       = 0.4984 V

VSENSOR = VCM - VFORCE
        = 2.0016 V
```

R14/R15使用0.1%、低温漂电阻。固件上报实测 `VCM - VFORCE`，不要只使用标称2.000 V计算阻值。

## 3. TIA量程

```text
RF = 12 kΩ，0.1%
CF = 47 nF，C0G
TIA_OUT = VCM + ISENSOR × RF
```

| 传感器电流 | 差分电压 | TIA输出 |
|---:|---:|---:|
| 0.2 µA | 2.4 mV | 2.5024 V |
| 1.6 µA | 19.2 mV | 2.5192 V |
| 16 µA | 192 mV | 2.692 V |
| 20 µA | 240 mV | 2.740 V |
| 25 µA | 300 mV | 2.800 V |

```text
fP = 1 / (2π × 12k × 47n) ≈ 282 Hz
```

反馈网络明显快于秒级气体响应。PCB完成后用传感器等效电容和阶跃输入确认是否有振铃；若需要，可在预留范围内调整Cf。

## 4. STM32 ADC量程与分辨率

STM32G030 12位ADC以VDDA为参考。按3.000 V估算：

```text
ADC_LSB = 3.000 / 4095
        = 0.7326 mV

I_LSB = 0.7326 mV / 12 kΩ
      = 61.05 nA/LSB
```

| 电流 | `TIA_OUT - VCM` | 理论差分码数 |
|---:|---:|---:|
| 0.2 µA | 2.4 mV | 约3.3 |
| 1.6 µA | 19.2 mV | 约26.2 |
| 16 µA | 192 mV | 约262 |
| 20 µA | 240 mV | 约328 |
| 25 µA | 300 mV | 约410 |

0.2 µA只有约3.3个理论原始码，不能仅靠12位ADC单次转换保证低端准确度；两个单端通道相减后，噪声近似为：

```text
σdiff ≈ √(σTIA² + σVCM²)
```

因此不能宣称单次转换具有1 nA绝对精度。建议：

- 启动时执行ADC校准
- 读取VREFINT估算实际VDDA
- 使用定时器触发固定序列扫描和DMA
- 同一采样帧内连续采集PA0、PA1、PA4
- 使用较长采样时间
- 通道切换后必要时丢弃首个样本
- 使用64–256次过采样/平均，再输出20–50 sample/s
- 在零电流或已知电流条件下保存 `Vzero` 与 `Rf_cal`
- 对BLE发射事件错峰或打时间标记

### 4.1 偏置通道

按3.0 V满量程估算：

```text
VCM ≈ 2.500 V       → 约3412码
VFORCE ≈ 0.4984 V   → 约680码
差值 ≈ 2.0016 V     → 约2732码
```

两个节点均在ADC输入范围内。

### 4.2 电池与USB通道

| 通道 | 分压 | 最大ADC输入 |
|---|---|---:|
| BAT_SENSE / PA5 | 1 MΩ / 1 MΩ | 4.2 V电池时2.10 V |
| VBUS_SENSE / PA6 | 1 MΩ / 1 MΩ | 5.25 V USB时2.625 V |

两路分压等效源阻较高，必须使用本地电容、长采样时间和VREFINT校正。VBUS最高输入低于3.0 V但余量不大，样机应验证LDO容差与ADC输入上限。

## 5. 电源边界

- STM32G030、VG6328A-Pro和ME6211C30输出工作在3.0 V
- BLE经FB1形成`BLE_3V0`，C20/C21在模块处承担脉冲电流
- 模拟前端经TPS22919和22 Ω滤波形成约2.99 V的`3VA`
- 模拟前端静态电流约0.30 mA，传感器主要电流0.2–1.6 µA，保护关断点25 µA
- 独立BLE模块连接时的平均电流可能高于原单SoC预估，续航以样机测试为准
- BAT低于3.25 V关闭`ANA_EN`；低于3.10 V关闭/休眠BLE并使STM32进入最低功耗
- 若使用小于100 mAh电池，必须降低TP4054充电电流

## 6. 上电验收点

| 测试点 | 允许范围或动作 |
|---|---|
| 3V0 | 2.94–3.06 V |
| BLE_3V0 | 与3V0接近；发射时不得异常跌落 |
| 3VA | `ANA_EN=1`后不低于约2.93 V |
| VREF_2V5_RAW | 25 °C初检2.4975–2.5025 V |
| VCM | 与VREF差值不大于3 mV |
| VFORCE | 0.495–0.502 V |
| VCM - VFORCE | 未校准样机1.990–2.010 V |
| TIA_OUT，传感器开路 | 接近VCM |
| 0.2 µA等效输入 | `TIA_OUT - VCM ≈ 2.4 mV` |
| 1.6 µA等效输入 | `TIA_OUT - VCM ≈ 19.2 mV` |
| 16 µA等效输入 | `TIA_OUT - VCM ≈ 192 mV` |
| 25 µA保护点 | `TIA_OUT - VCM ≈ 300 mV` |
| RESET_N | 上电后高，ST-LINK可拉低复位 |
| SWD | 能识别、擦除、烧录并断点运行 |
| BLE UART | AT响应正确，TX/RX无交叉错误 |
| ANA_EN关断 | 3VA按预期放电到低电平 |

## 7. 校准建议

使用0.1%、低温漂电阻模拟至少五个点：

| 目标电流 | 2 V下等效电阻 |
|---:|---:|
| 0.2 µA | 10 MΩ |
| 1.6 µA | 1.25 MΩ |
| 16 µA | 125 kΩ |
| 20 µA | 100 kΩ |
| 25 µA | 80 kΩ |

实际阻值应按实测偏置电压修正，不只按标称2.000 V计算。记录原始ADC码、VREFINT、温度和上传值；至少保存零点、反馈增益和实际偏置三个参数。

## 8. 主要器件

| 器件 | 关键理由 | 立创编号 |
|---|---|---|
| STM32G030F6P6TR | 常见STM32、12位ADC、SWD、TSSOP-20 | C529330 |
| VG6328A-Pro | 低成本BLE/UART模块、板载天线 | C53263476 |
| GZ1005D601TF | BLE电源高频隔离，0402 | C14182 |
| TP4054 | 小型单节锂电充电 | C668215 |
| ME6211C30M5G | 低成本3.0 V LDO | C94042 |
| TPS22919DCKR | 小封装、低关断电流、QOD | C2149796 |
| LM4040A25IDBZR | 2.5 V、0.1%基准 | C9421 |
| TLV9002IDGKR | 低成本双RRIO运放 | C398361 |
| OPA391DCKR | 低失调、低输入偏置电流 | C2871876 |

## 9. 资料

- [STM32G030F6数据手册](https://www.st.com/resource/en/datasheet/stm32g030f6.pdf)
- [VG6328A-Pro模块资料](https://atta.szlcsc.com/upload/public/pdf/source/20260701/2E43CC04C6263D77978C2A5830BC3F43.pdf)
- [TI LM4040数据手册](https://www.ti.com/lit/ds/symlink/lm4040.pdf)
- [TI TLV9002数据手册](https://www.ti.com/lit/ds/symlink/tlv9002.pdf)
- [TI OPA391数据手册](https://www.ti.com/lit/ds/symlink/opa391.pdf)
- [TI TPS22919数据手册](https://www.ti.com/lit/ds/symlink/tps22919.pdf)
