orange445/portable-gas-sensor-stm32/docs/06_低成本替换与验收.md

# 06 低成本替换与验收

版本：V0.1  
价格快照：2026-07-26  
范围：把STM32WB1MMCH6TR单模块方案改为常见STM32主控加独立蓝牙模块

## 1. 冻结方案

| 功能 | 原方案 | 当前方案 |
|---|---|---|
| 主控 | STM32WB1MMCH6TR内部M4 | STM32G030F6P6TR |
| ADC | WB模块内部ADC | STM32G030 12位ADC |
| BLE | WB模块内部BLE | VG6328A-Pro UART模块 |
| 烧录 | WB模块SWD | STM32 SWD五针Pogo焊盘 |
| 天线 | WB模块天线 | VG6328A-Pro板载PCB天线 |
| 主控封装 | LGA-77 | TSSOP-20 |

选择STM32G030的原因：

- 常见STM32开发流程，ST-LINK、CubeMX和HAL/LL工具链成熟
- 32 KB Flash、8 KB RAM足够完成ADC、滤波、校准、UART和状态机
- 12位ADC支持硬件过采样；12 kΩ宽量程TIA覆盖主要0.2–1.6 µA信号，但低端仅有少量原始差分码，必须通过样机校准和噪声测试确认有效分辨率
- TSSOP-20可手工焊接和返修，首版调试风险低
- BLE协议栈和射频由独立模块承担，STM32固件不需要运行无线协议栈

## 2. 主控无线部分成本对比

以下为立创商城公开页面的含税/促销状态可能变化的参考价格，不包含无源器件：

| 数量 | STM32WB1MMCH6TR | STM32G030F6P6TR | VG6328A-Pro | 新方案合计 | 参考降幅 |
|---:|---:|---:|---:|---:|---:|
| 1 | US$13.84 | US$1.23 | US$0.81 | US$2.04 | 约85% |
| 10 | US$13.50/片 | US$1.09/片 | US$0.65/片 | US$1.74/套 | 约87% |

FB1和三只新增去耦/复位电容的成本远低于主芯片差价，因此不会改变结论。价格和库存会波动，量产前必须重新锁定供应渠道。

参考页面：

- [STM32WB1MMCH6TR / C5456183](https://www.lcsc.com/product-detail/bluetooth-modules_stmicroelectronics-stm32wb1mmch6tr_C5456183.html)
- [STM32G030F6P6TR / C529330](https://www.lcsc.com/product-detail/Microcontroller-Units-MCUs-MPUs-SOCs_STMicroelectronics-STM32G030F6P6TR_C529330.html)
- [VG6328A-Pro / C53263476](https://www.lcsc.com/product-detail/C53263476.html)

## 3. 面积与功耗取舍

新方案的成本明显降低，但VG6328A-Pro为14.5 × 11.5 mm模块，所以总数字/射频面积会大于6.5 × 10 mm的STM32WB模块。通过以下措施控制整板面积：

- STM32使用6.5 × 4.4 mm TSSOP-20
- C16/C20统一为0603，其他数字去耦优先0402
- SWD使用不装器件的5针SMD Pogo焊盘
- BLE模块顶到PCB边缘，其天线禁布区与板外空间重叠
- 主控放在BLE模块内侧，UART只需短距离连接

预计数字/射频功能块约22 × 16 mm，整板仍可向约35 × 25 mm目标优化。

独立蓝牙模块典型工作电流约5 mA，会高于高度优化的单芯片BLE休眠方案。低成本版应通过增大广播/连接间隔、批量发送和模块睡眠降低平均电流；续航必须以样机实测为准。

## 4. 实际EDA工程验收证据

当前主原理图三页共59个实体器件，API扫描结果：

- 未发现nRF、MDBT或STM32WB器件
- U7为STM32G030F6P6TR，TSSOP-20，加入BOM和PCB
- U8为VG6328A-Pro，加入BOM和PCB
- FB1、C20、C21构成BLE独立供电滤波
- C16已改为C1705 4.7 µF/0603并重新接通3V0与GND
- J4为5针SMD Pogo封装，不进入BOM但加入PCB
- J4五针依次连接3V0、SWDIO、SWDCLK、RESET_N和GND
- 严格原理图DRC：0错误、保留4条既有非电气提示

RS1仍是传感器电气模型，不进入PCB/BOM。进入PCB前必须根据实际传感器形态建立电极、焊盘或连接器封装，这属于传感器机械接口冻结项，不是STM32替换遗留。

## 5. 固件与生产风险

- USART2使用PA2/PA3连接蓝牙模块，TX/RX已经交叉
- TSSOP-20共封装脚上的未用GPIO必须保持模拟输入
- PA13/PA14保持SWD功能，量产固件不得过早重映射
- 首版使用STM32内部时钟；若115200 bit/s在全温范围出现UART错误，可降至57600或加入时钟校准
- BLE模块只承担无线透传，STM32失去模块响应时仍必须继续采样并触发超时恢复
- iOS/Android产品通信应基于BLE服务，不把经典蓝牙SPP作为唯一通道
