orange445/portable-gas-sensor-stm32/docs/images/01_Power_Charge.png

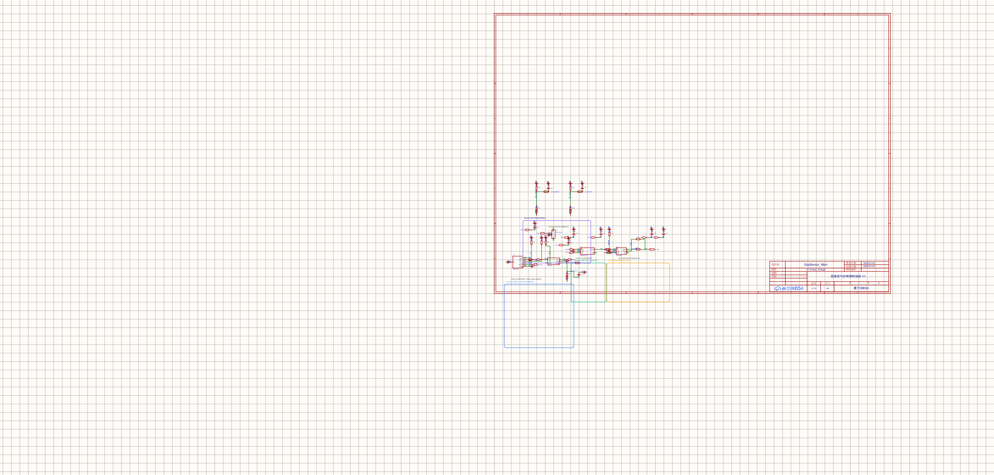
docs/images/01_Power_Charge.png
