orange445/portable-gas-sensor-stm32/docs/images/06_硬件整体电流图.png

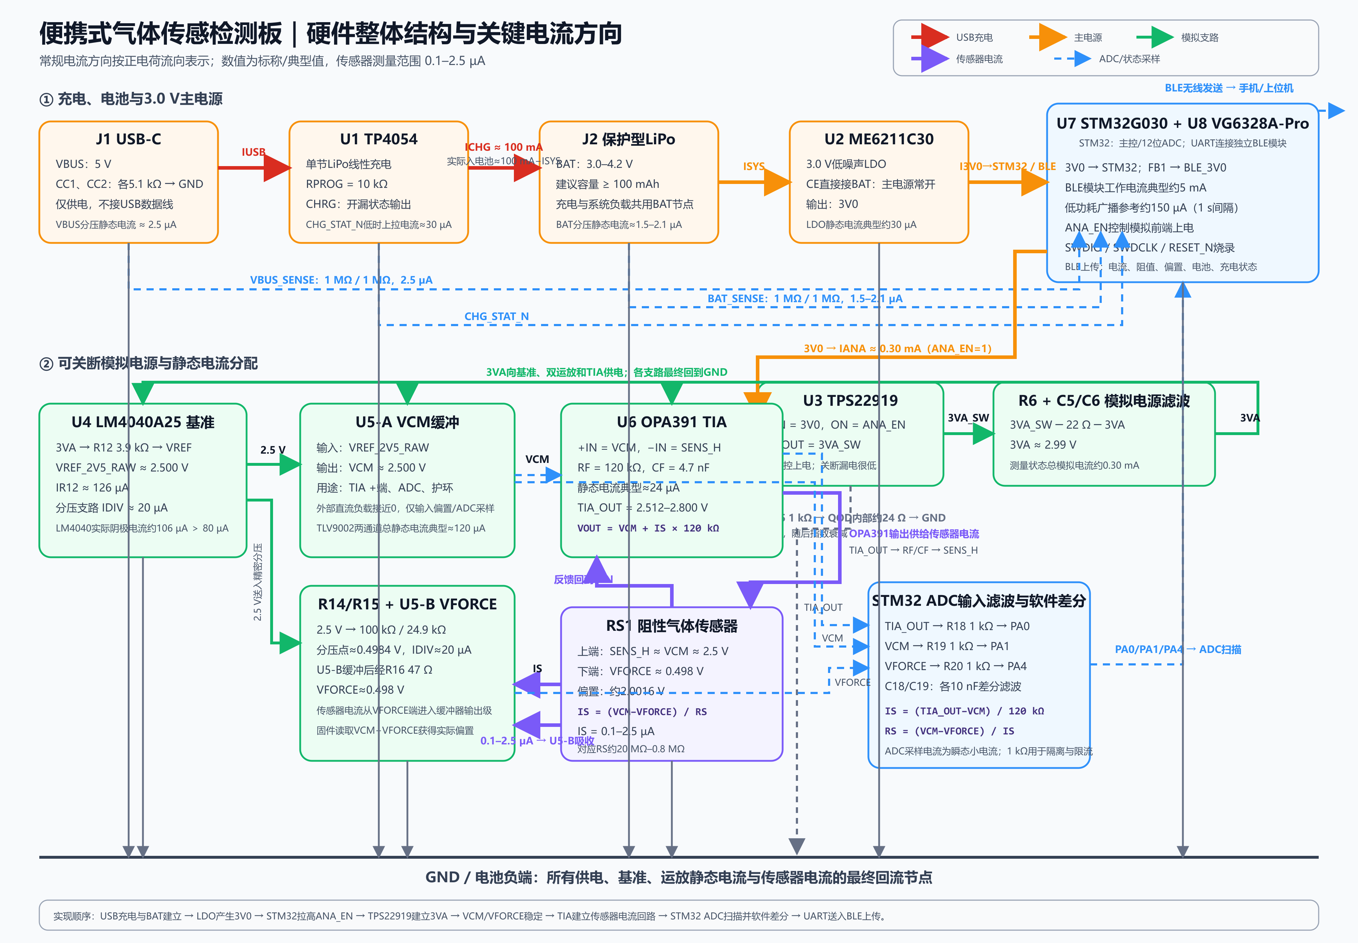
docs/images/06_硬件整体电流图.png
