orange445/portable-gas-sensor-stm32/BOM/BOM_Board1_PCB1_2026-07-29.xlsx

No. | Quantity | Comment | Designator | Footprint | Value | Manufacturer Part | Manufacturer | Supplier Part | Supplier
1 | 2 | 4.7uF | C1,C2 | C0805 | 4.7uF | CL21A475KAQNNNE | SAMSUNG(三星) | CL21A475KAQNNNE.1 | LCSC
2 | 4 | 1uF | C3,C4,C5,C15 | C0603 | 1uF | CL10A105KB8NNNC | SAMSUNG(三星) | CL10A105KB8NNNC.1 | LCSC
3 | 9 | 100nF | C6,C9,C10,C11,C12,C14,C17,C21,C22 | C0402 | 100nF | CL05B104KO5NNNC | SAMSUNG(三星) | CL05B104KO5NNNC.1 | LCSC
4 | 4 | 10nF | C7,C8,C18,C19 | C0402 | 10nF | CL05B103KB5NNNC | SAMSUNG(三星) | CL05B103KB5NNNC.1 | LCSC
5 | 1 | 47nF C0G | C13 | C1206 | 47nF | C3216C0G1H473J115AA | TDK | C2170734 | LCSC
6 | 1 | 4.7uF | C16 | C0603 | 4.7uF | CL10A475KP8NNNC | SAMSUNG(三星) | C1705 | LCSC
7 | 1 | 4.7uF | C20 | C0603 | 4.7uF | CL10A475KP8NNNC | SAMSUNG(三星) | CL10A475KP8NNNC.1 | LCSC
8 | 1 | 10nF | C23 | C0402 | 10nF | CL05B103KB5NNNC | SAMSUNG(三星) | C15195 | LCSC
9 | 1 | GZ1005D601TF | FB1 | L0402 |  | GZ1005D601TF | Sunlord(顺络) | GZ1005D601TF.1 | LCSC
10 | 1 | USB-C-6P | J1 | TYPE-C-SMD_TYPE-C-6P |  | TYPE-C-6P-DIP2X2 |  | TYPE-C-6P-DIP2X2.1 | LCSC
11 | 1 | BAT_PH2.0 | J2 | CONN-SMD_2P-P2.00 |  | PH2.0-2P-SMD |  | PH2.0-2P-SMD.1 | LCSC
12 | 2 | 5.1k | R1,R2 | R0402 | 5.1k | 0402WGF5101TCE | UNI-ROYAL(厚声) | 0402WGF5101TCE.1 | LCSC
13 | 2 | 10k | R3,R21 | R0402 | 10k | 0402WGF1002TCE | UNI-ROYAL(厚声) | 0402WGF1002TCE.1 | LCSC
14 | 2 | 100k | R4,R7 | R0402 | 100k | 0402WGF1003TCE | UNI-ROYAL(厚声) | 0402WGF1003TCE.1 | LCSC
15 | 4 | 1k | R5,R18,R19,R20 | R0402 | 1k | 0402WGF1001TCE | UNI-ROYAL(厚声) | 0402WGF1001TCE.1 | LCSC
16 | 1 | 22 | R6 | R0402 | 22 | 0402WGF220JTCE | UNI-ROYAL(厚声) | 0402WGF220JTCE.1 | LCSC
17 | 4 | 1M | R8,R9,R10,R11 | R0402 | 1M | 0402WGF1004TCE | UNI-ROYAL(厚声) | 0402WGF1004TCE.1 | LCSC
18 | 1 | 3.9k | R12 | R0402 | 3.9k | 0402WGF3901TCE | UNI-ROYAL(厚声) | 0402WGF3901TCE.1 | LCSC
19 | 1 | 100 | R13 | R0402 | 100 | 0402WGF1000TCE | UNI-ROYAL(厚声) | 0402WGF1000TCE.1 | LCSC
20 | 1 | 100k 0.1% 25ppm | R14 | R0402 | 100k 0.1% 25ppm | RT0402BRD07100KL | YAGEO(国巨) | C852472 | LCSC
21 | 1 | 24.9k 0.1% 25ppm | R15 | R0402 | 24.9k 0.1% 25ppm | RT0402BRD0724K9L | YAGEO(国巨) | C852664 | LCSC
22 | 1 | 47 | R16 | R0402 | 47 | 0402WGF470JTCE | UNI-ROYAL(厚声) | 0402WGF470JTCE.1 | LCSC
23 | 1 | 12k 0.1% 25ppm | R17 | R0603 | 12kΩ | ERA3AEB123V | PANASONIC(松下) | C473243 | LCSC
24 | 1 | TP4054 | U1 | TSOT-23-5_L2.9-W1.6-P0.95-LS2.8-BR |  | TP4054 | UMW(友台半导体) | TP4054_C668215.1 | LCSC
25 | 1 | ME6211C30 | U2 | SOT-23-5_L3.0-W1.7-P0.95-LS2.8-BR |  | ME6211C30M5G | MICRONE(南京微盟) | ME6211C30M5G.1 | LCSC
26 | 1 | TPS22919 | U3 | SC-70-6_L2.2-W1.3-P0.65-LS2.1-BR |  | TPS22919DCKR | TI(德州仪器) | TPS22919DCKR.1 | LCSC
27 | 1 | LM4040A25IDBZR | U4 | SOT-23-3_L2.9-W1.6-P1.90-LS2.8-BR |  | LM4040A25IDBZR | TI(德州仪器) | LM4040A25IDBZR.1 | LCSC
28 | 1 | TLV9002IDGKR | U5 | VSSOP-8_L3.0-W3.0-P0.65-LS5.0-BL |  | TLV9002IDGKR | TI(德州仪器) | TLV9002IDGKR.1 | LCSC
29 | 1 | OPA391DCKR | U6 | SC-70-5_L2.1-W1.3-P0.65-LS2.1-BR |  | OPA391DCKR | TI(德州仪器) | OPA391DCKR.1 | LCSC
30 | 1 | STM32G030F6P6TR | U7 | TSSOP-20_L6.5-W4.4-P0.65-LS6.4-BL |  | STM32G030F6P6TR | ST(意法半导体) | STM32G030F6P6TR.1 | LCSC
31 | 1 | VG6328A-Pro | U8 | COMM-SMD_L14.5-W11.5_VG6328A-PRO |  | VG6328A-Pro | Vollgo(沃进) | VG6328A-PRO.1 | LCSC
