orange445/portable-gas-sensor-stm32/firmware/cubemx/Core/Inc/main.h

#define AIN_TIA_Pin GPIO_PIN_0
#define AIN_TIA_GPIO_Port GPIOA
#define AIN_VCM_Pin GPIO_PIN_1
#define AIN_VCM_GPIO_Port GPIOA
#define BLE_UART_TX_Pin GPIO_PIN_2
#define BLE_UART_TX_GPIO_Port GPIOA
#define BLE_UART_RX_Pin GPIO_PIN_3
#define BLE_UART_RX_GPIO_Port GPIOA
#define AIN_VFORCE_Pin GPIO_PIN_4
#define AIN_VFORCE_GPIO_Port GPIOA
#define BAT_SENSE_Pin GPIO_PIN_5
#define BAT_SENSE_GPIO_Port GPIOA
#define VBUS_SENSE_Pin GPIO_PIN_6
#define VBUS_SENSE_GPIO_Port GPIOA
#define CHG_STAT_N_Pin GPIO_PIN_7
#define CHG_STAT_N_GPIO_Port GPIOA
#define ANA_EN_Pin GPIO_PIN_0
#define ANA_EN_GPIO_Port GPIOB
#define I2C_SCL_Pin GPIO_PIN_11
#define I2C_SCL_GPIO_Port GPIOA
#define I2C_SDA_Pin GPIO_PIN_12
#define I2C_SDA_GPIO_Port GPIOA
#define BLE_WAKE_Pin GPIO_PIN_6
#define BLE_WAKE_GPIO_Port GPIOB
